steve-nelson/star-destroyer-lighting/(commit log)

2026-10-15 Add Star Destroyer v1 lighting build pack
    Breadboard test diagrams and sketches (testing/), the build guide,
    perfboard build-in-stages sheet, main sketch and sketch explainer (build/).
    Boards: two 5 x 7 cm perfboards with JST XH sockets on every channel.
    Claude-Session: https://claude.ai/code/session_01Eg3zYEdu9wDJpn5Gi9TjSR
2026-10-17 Add accent lights (channel 20) and mark design as breadboard-proven
    - Six SMD accent LEDs on Nano A2 -> Driver C input 8, output pin 11 to a
    new upright JST XH Accent header on Board 1 (R6/S6); wire 9 removed,
    new wires 39-41
    - Junction stripboard drawings, parts and tests in the build guide and
    perfboard stages
    - Main sketch: PWM fade-up/fade-out for the accent channel; random seed
    now from esp_random() since A2 is in use
    - Pin tester includes the accent channel
    - Driver input tests now say to remove the Nano before applying +5 V
    - README: remove the "not yet proven" status
    Claude-Session: https://claude.ai/code/session_01Eg3z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
2026-10-18 Move the accent socket to the right-hand edge of Board 1
    The upright header at R6/S6 left no room to insert the plug. The accent
    channel now uses a right-angle JST XH socket at X6 (+5 V) / X7 (OUT),
    opening facing off the board edge. Wire 40 runs along row 7 to X7; wire
    41 runs down column X to the +5 V bus at X1.
    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
2026-10-18 Move the accent socket to column T (T6 +5 V, T7 OUT)
    The thick +5 V wire from the box header down column W left no room for
    the plug at X6/X7. The right-angle accent socket now sits at T6 (+5 V) /
    T7 (OUT), opening facing right. Wire 40 runs along row 7 to T7; wire 41
    runs from T6 across to U6 and down column U to the +5 V bus at U1.
    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
2026-10-18 Label the box-header signal wires green and fit them before the blue wires
    - Wires 27-38 (Board 1) and 3-14 (Board 2) are now drawn and listed as
    Green instead of Teal
    - Stage 5 fits the green wires first: several solder to the Nano's row 10
    pins, which the blue wires 1-7 pass between, so this keeps the iron away
    from the blue insulation; Kapton note for any later re-soldering
    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
2026-10-18 Board 2: right-angle sockets, right-hand four stacked down column U
    The four right-hand connectors (Hull 9, Hull 10, Bridge, Hangar) did not
    leave room to insert the plugs. Board 2 now uses right-angle XH sockets
    throughout: Hull 1-8 along the bottom edge as before, and the four
    right-hand sockets stacked down column U with openings facing the right
    edge (+5 V at U16/U13/U10/U7, OUT at U17/U14/U11/U8). Driver B outputs
    and +5 V wires rerouted; Driver A output lanes lowered below row 7.
    Parts lists: 20 right-angle sockets, no vertical headers.
    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
2026-10-20 Board 2 split layout; hangar bay moves to Board 1
    - Board 2 sockets grouped by where the leads go: Hull 1-5 down the left
    edge (column C), Hull 6-9 down the right edge (column V), Hull 10
    (raised upper hull), Bridge and Accent on the stern edge (row 3)
    - Driver A fitted notch down (pin 1 at H8); ribbon box header upright
    between the drivers (J/K, pin 1 at J16); +5 V risers up columns B and W
    - Hangar bay now on the Board 1 T6/T7 socket (Nano A2, Driver C input 8);
    accent lights now on Board 2 (Nano D10, Driver B input 1)
    - Main sketch: HANGAR_PIN = A2, ACCENT_PIN = D10, HULL_PINS in Board 2
    socket order; pin tester order updated
    - Guides, pin maps, driver diagrams, harness and wire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
2026-10-20 Bridge becomes a 4-LED cluster; Hull 10 moves to Board 2's right edge
    - Bridge cluster: 4 LEDs (2 bridge towers, 2 raised upper-hull section);
    LED counts and parts list updated (55 fibre LEDs + 6 SMD accents)
    - Hull 10 socket moves from the stern edge to the right edge under Hull 9
    (V4 +5 V / V5 OUT), giving 5 sockets per side; stern edge keeps Bridge
    and Accent. Wire 21 rerouted, Hull 10 +5 V now taps the column W riser
    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
2026-10-20 Board 2: centre the drivers and box header
    Driver A (G-J, notch down, pin 1 at J7), box header (L-M rows 15-9, pin 1
    at L15) and Driver B (O-R, pin 1 at O15) now sit in the middle of the
    board, equally spaced from the left and right socket columns and from the
    stern sockets and the top bus. Board 2 rerouted (43 wires, net check
    clean); hull-to-Nano pin pairing updated in the sketch, pin tester,
    tables, pin map and driver diagrams.
    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
2026-10-20 Board 2: bridge on an upright XH header
    The bridge lead comes straight down from the upper hull, so its Board 2
    connector (J3/K3) is now an upright B2B-XH-A header; the accent stays a
    right-angle socket. Parts lists: 19 right-angle sockets, 1 vertical header.
    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
2026-10-24 Fix Board 2 left-edge sockets: +5 V on the upper pin
    The left-edge right-angle sockets face the opposite way to the right-edge
    ones, so their pin 1 (+5 V) is the upper pin, not the lower. Hull 1-5 now
    have +5 V at C17, C14, C11, C8, C5 and OUT at C16, C13, C10, C7, C4; the
    left riser taps and the Driver A output wires are rerouted to match.
    Net check clean.
    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
2026-10-25 Board 2 box header: pin 1 on the key side (M15)
    The Board 2 box header pin numbering was drawn mirror-image, so a standard
    keyed ribbon cable swapped each pin pair (+5 V with GND, D9 with D10 ...).
    Board 2 now has pin 1 at M15 (odd pins down column M, the key side) with
    wire 1 (+5 V) from M15 and wire 2 (GND) from L15. The swapped signal pairs
    are handled in the sketch: BRIDGE_PIN = D10, ACCENT_PIN = D9 and the hull
    pins re-paired; pin tester, tables, pin map and driver diagrams updated.
    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
    [pin_test_nano.ino]
2026-10-25 Bridge header: lock ramp toward the drivers
    An upright XH header has its pin 1 on the opposite side to the right-angle
    sockets, so the Bridge header on Board 2 is fitted with its lock ramp
    toward the drivers to put pin 1 (+5 V) on J3. Drawings and build steps
    updated. Both boards tested: all 20 channels working.
    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
